julienrat/petitbot/Shield/readme.md

## Shield Petit Bot
Fichier Gerber utilisable directement sur le site JCLPCB : [https://jlcpcb.com/]

| DESSUS  | DESSOUS |
| --- | --- |
| My Image | My Image |

N'oubliez pas de paneliser en indiquant Panel by JCLPCB, 4 colonnes et 3 lignes. 

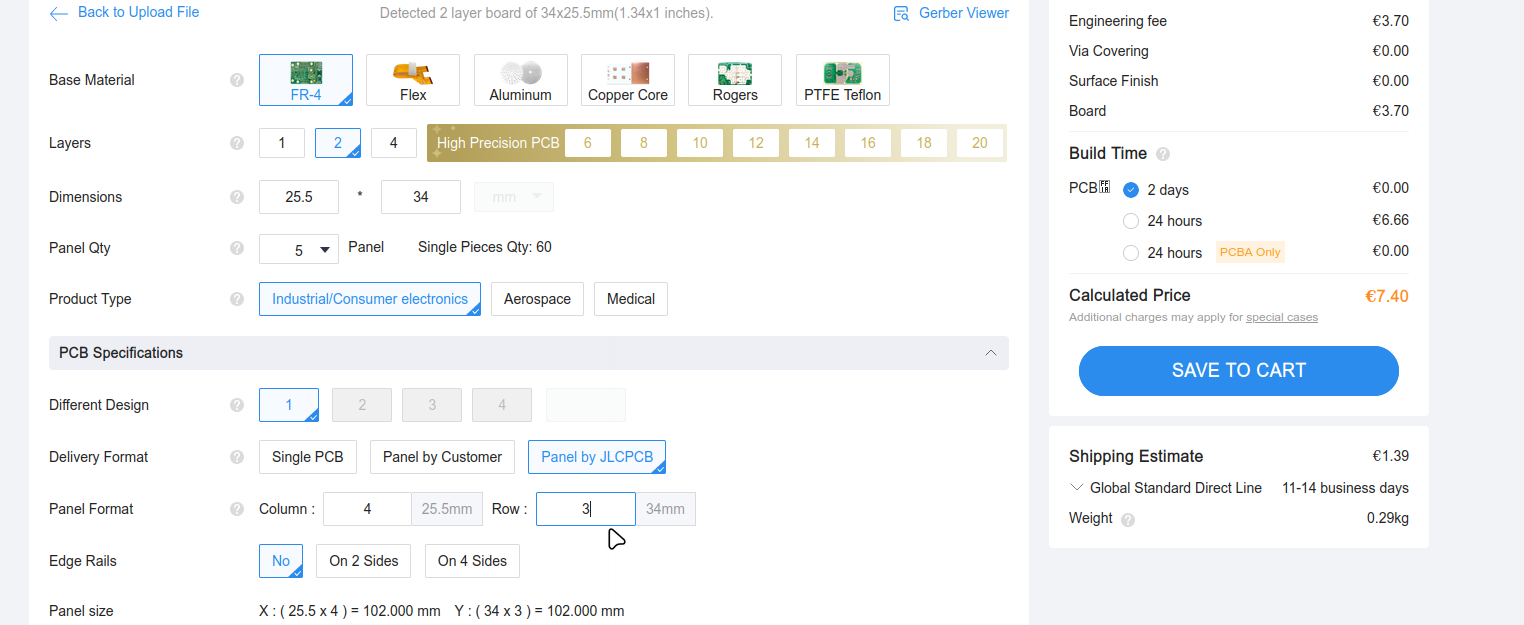
[picture p13: Shield/JCLPCB_TUTO.png]
My Image
