julienrat/petitbot/code_arduino/petitbot_v4/readme.md

ATTENTION ! ce code fonctionne désormais avec la derniere version la bibliothèque ArduinoJson v6
