julienrat/petitbot/code_arduino/petitbot_v4/data/images/bot_carton.jpg

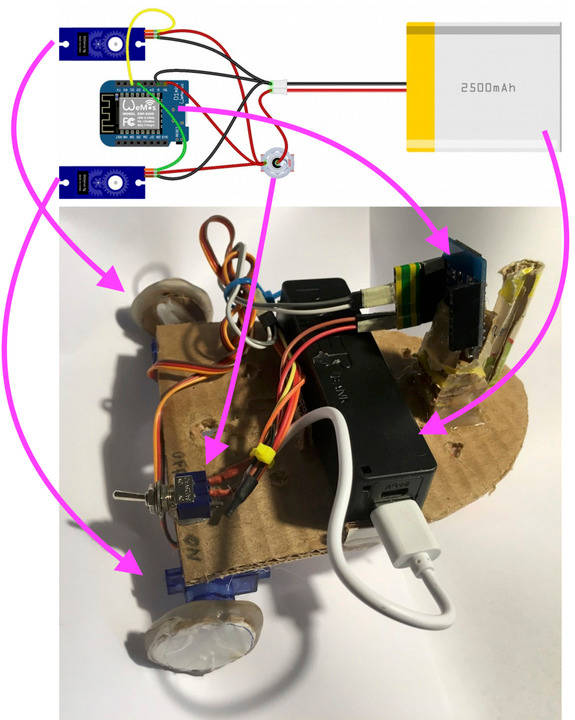
code_arduino/petitbot_v4/data/images/bot_carton.jpg
