julienrat/petitbot/code_arduino/petitbot_v4/data/images/petitbot1.jpg

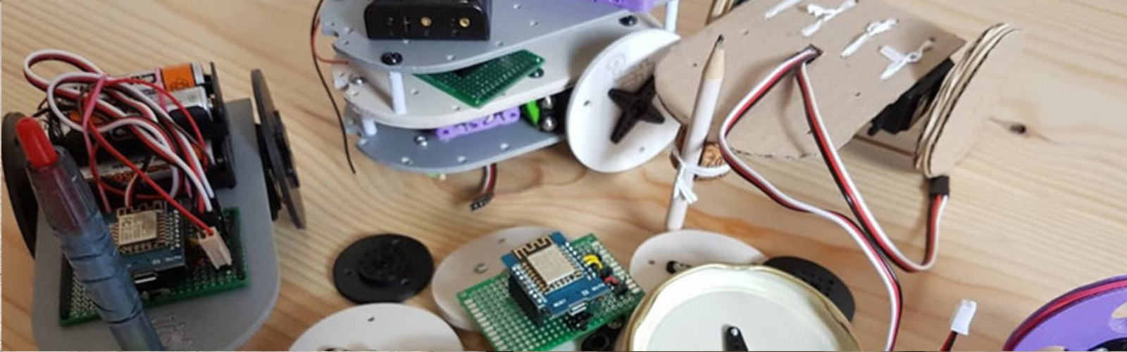
code_arduino/petitbot_v4/data/images/petitbot1.jpg
