julienrat/petitbot/code_arduino/petitbot_v4/data/images/petitbot4_low.jpg

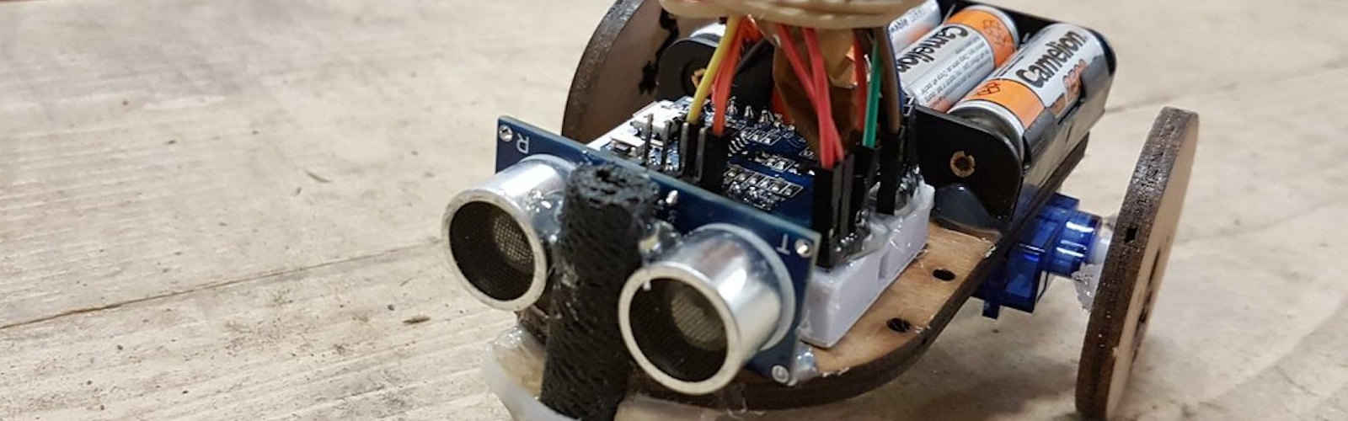
code_arduino/petitbot_v4/data/images/petitbot4_low.jpg
