julienrat/petitbot/code_arduino/petitbot_v4/data/images/servo.jpg

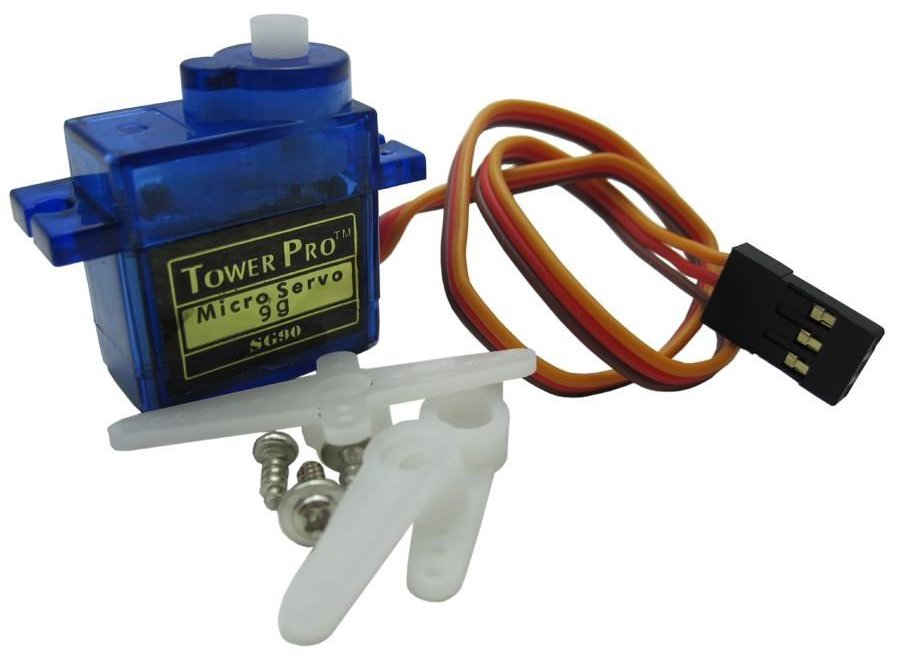
code_arduino/petitbot_v4/data/images/servo.jpg
