julienrat/petitbot/code_arduino/petitbot_v4/data/images/servo_colle.jpg

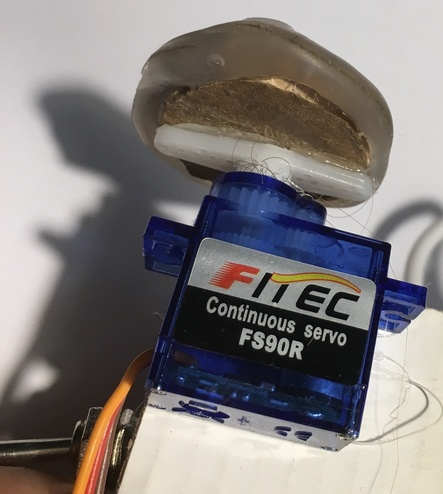
code_arduino/petitbot_v4/data/images/servo_colle.jpg
