julienrat/petitbot/images/5-pcs-9g-Mini-360-Degree-Continuous-Rotation-Robot-Servo-FS90R.jpg

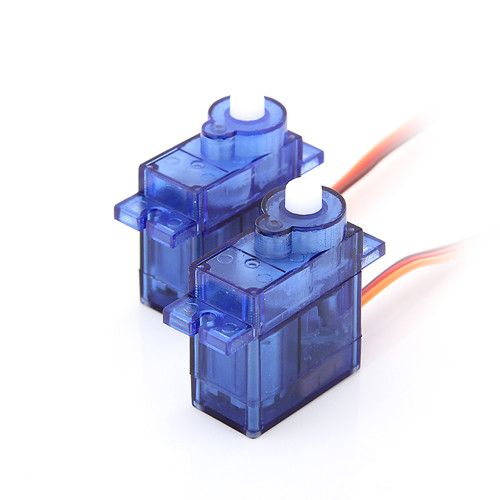
images/5-pcs-9g-Mini-360-Degree-Continuous-Rotation-Robot-Servo-FS90R.jpg
