julienrat/petitbot/images/10-Pcs-Per-Lot-font-b-2mm-b-font-font-b-Pitch-b-font-8-Pin.jpg

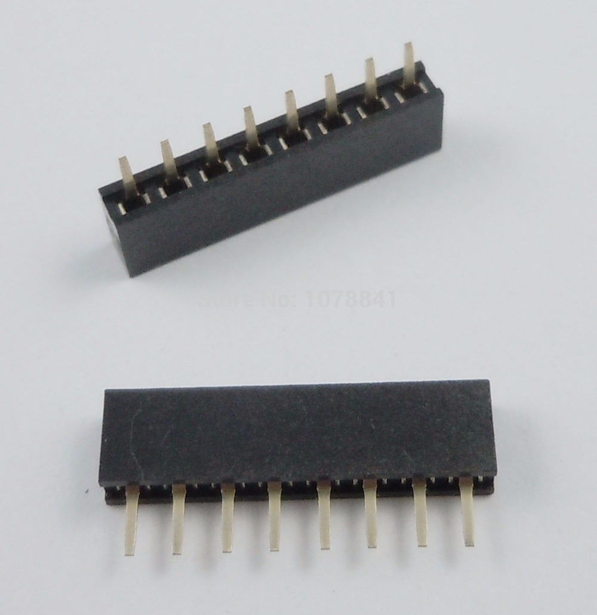
images/10-Pcs-Per-Lot-font-b-2mm-b-font-font-b-Pitch-b-font-8-Pin.jpg
