julienrat/petitbot/images/701343_ZB_00_FB.EPS_1000.jpg

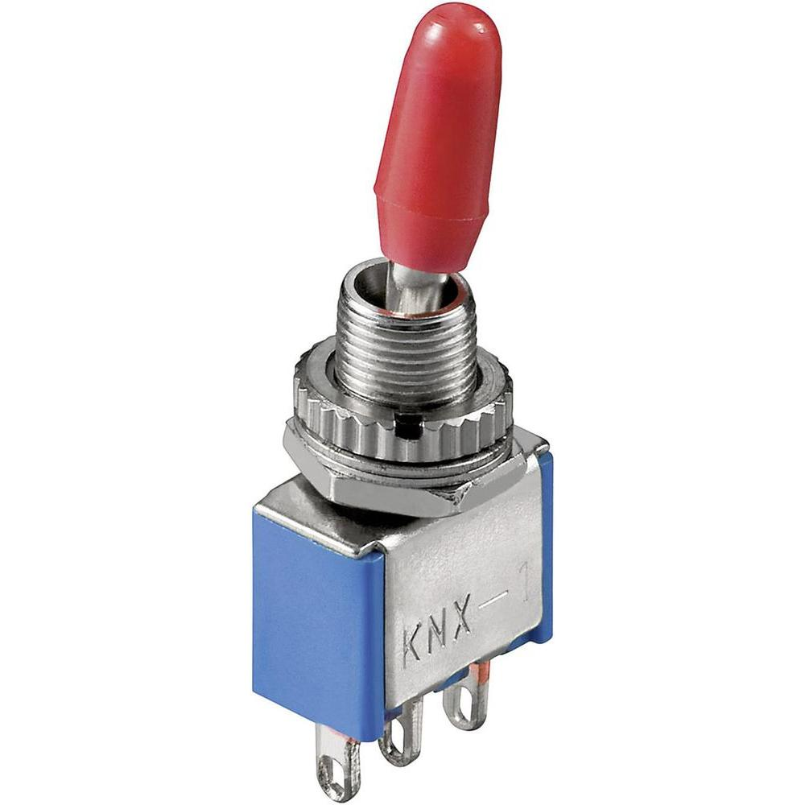
images/701343_ZB_00_FB.EPS_1000.jpg
