julienrat/petitbot/images/20170923_175443.jpg

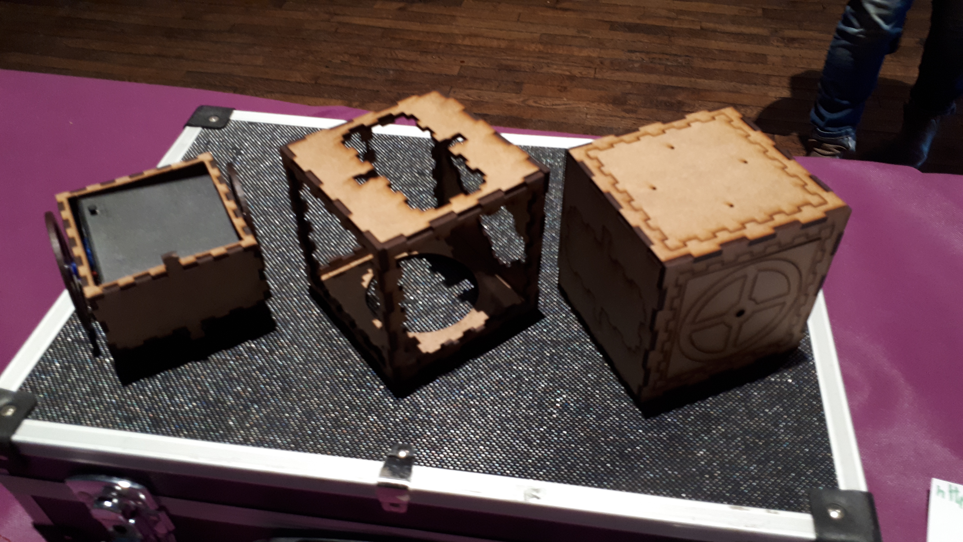
images/20170923_175443.jpg
