julienrat/petitbot/images/appinventor2.png

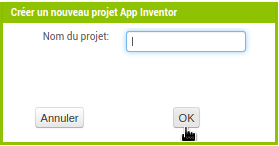
images/appinventor2.png
