julienrat/petitbot/images/appinventor3.png

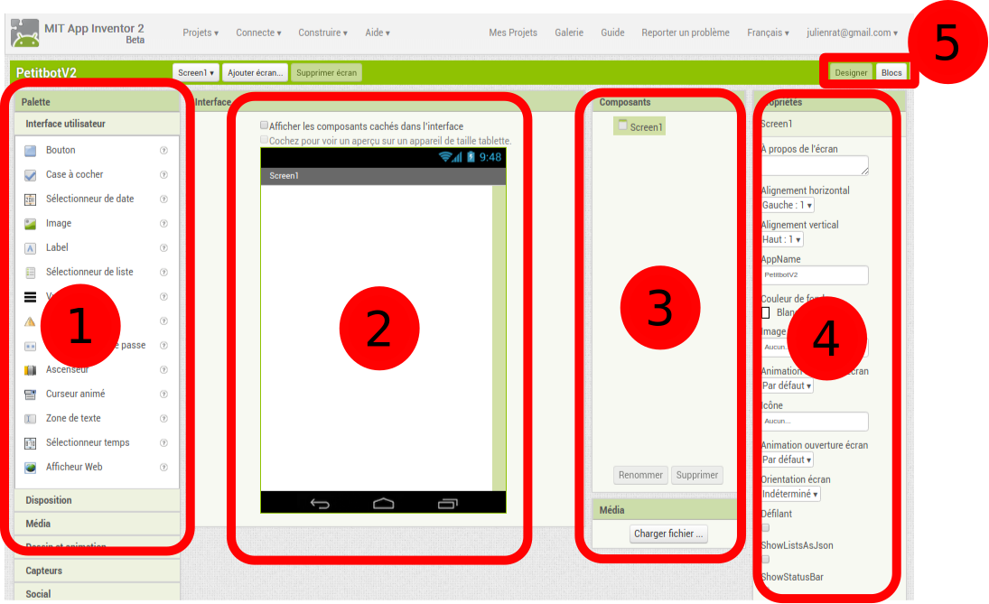
images/appinventor3.png
