julienrat/petitbot/images/appinventor5.png

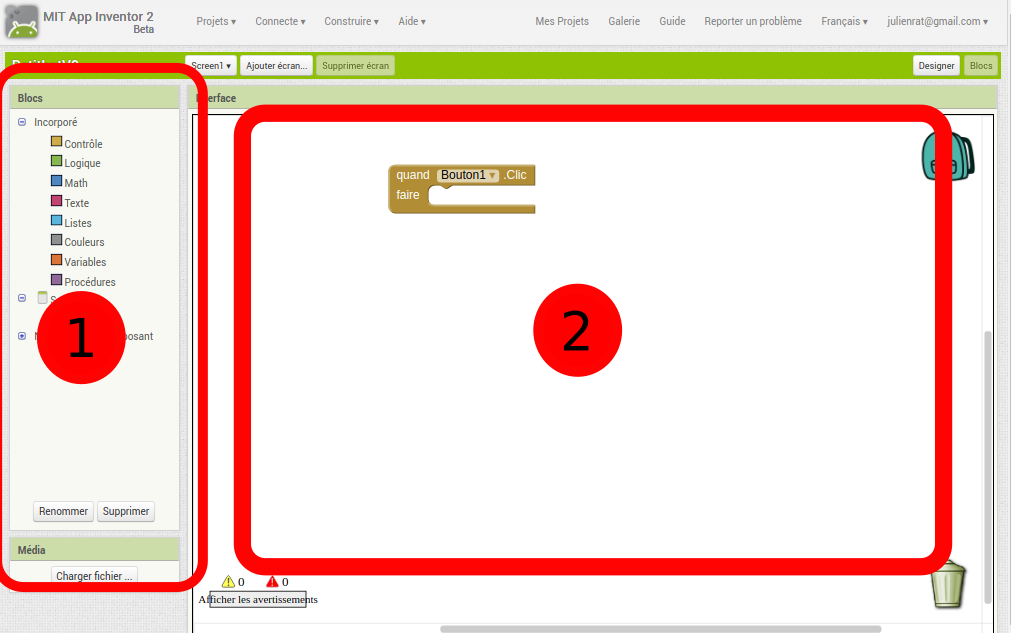
images/appinventor5.png
