julienrat/petitbot/images/appinventor6.png

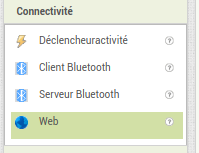
images/appinventor6.png
