julienrat/petitbot/images/appinventor7.png

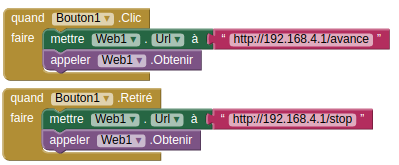
images/appinventor7.png
