julienrat/petitbot/images/appinventor9.png

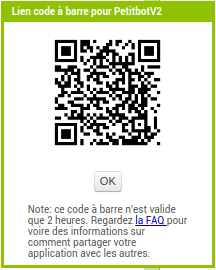
images/appinventor9.png
