julienrat/petitbot/images/C3WkAJDWcAAZ7_t.jpg

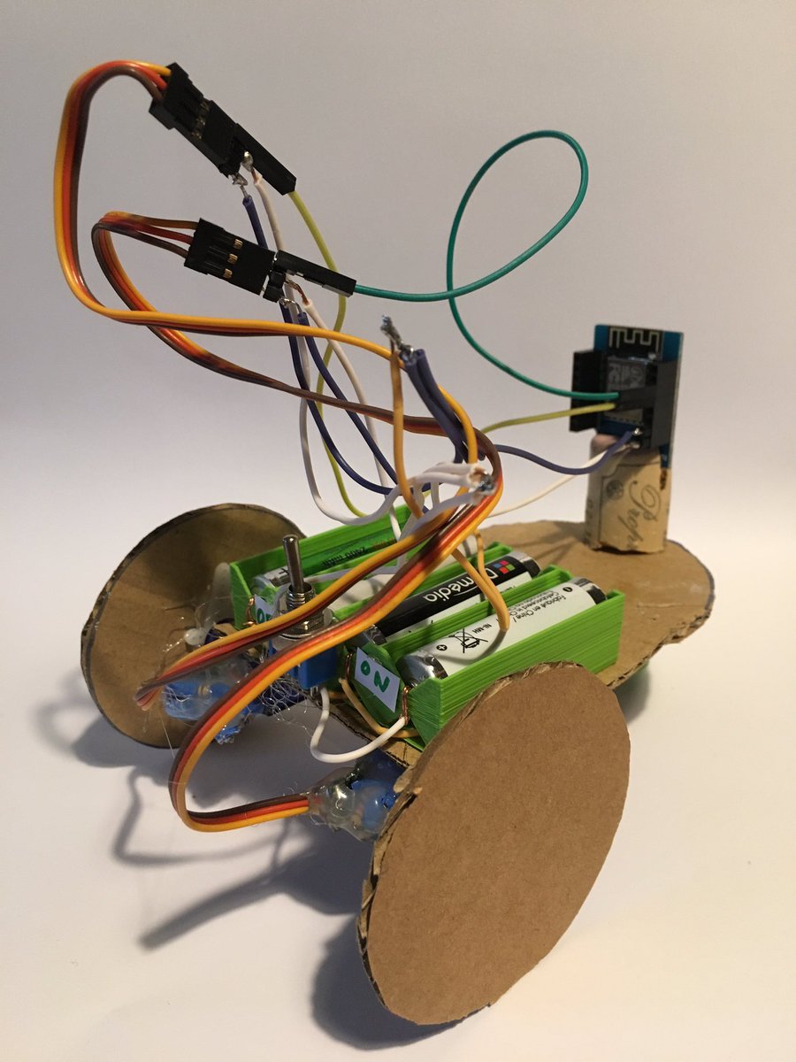
images/C3WkAJDWcAAZ7_t.jpg
