julienrat/petitbot/images/C3WkAJdWcAIOfmc.jpg

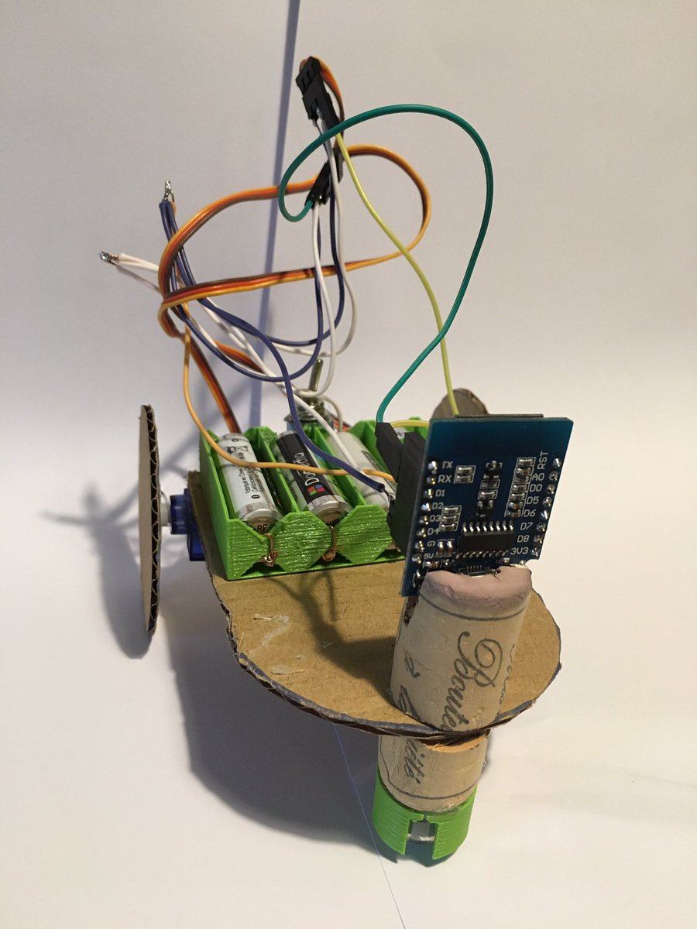
images/C3WkAJdWcAIOfmc.jpg
