julienrat/petitbot/images/C6-DNaoXAAEp5Ra.jpg

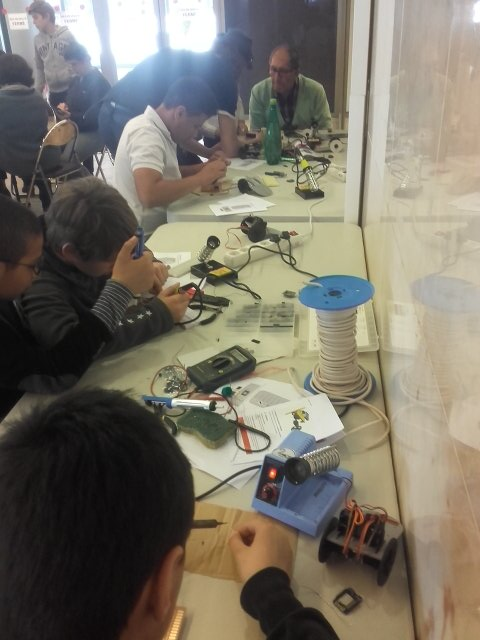
images/C6-DNaoXAAEp5Ra.jpg
