julienrat/petitbot/images/C6-DO8nXEAAV2lQ.jpg

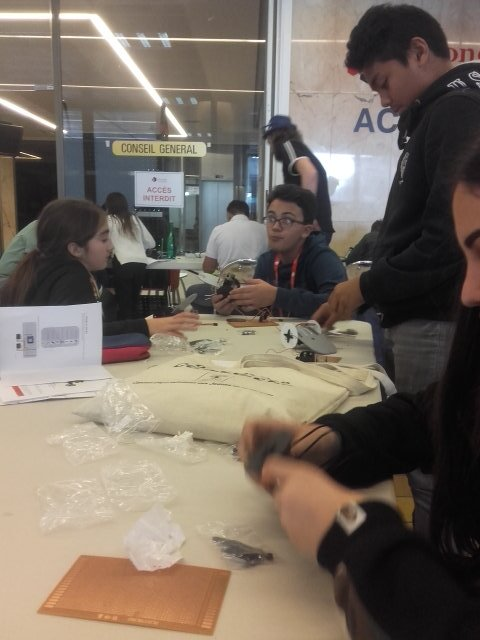
images/C6-DO8nXEAAV2lQ.jpg
