julienrat/petitbot/images/C-5D0mgXoAE_1XM.jpg

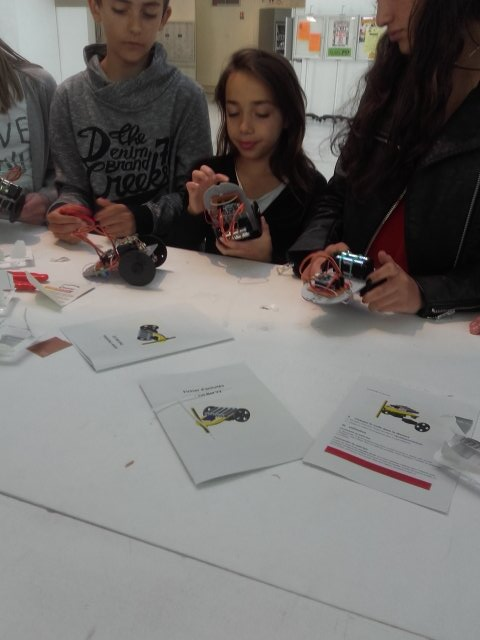
images/C-5D0mgXoAE_1XM.jpg
