julienrat/petitbot/images/C-5DqKEXUAAd2nf.jpg

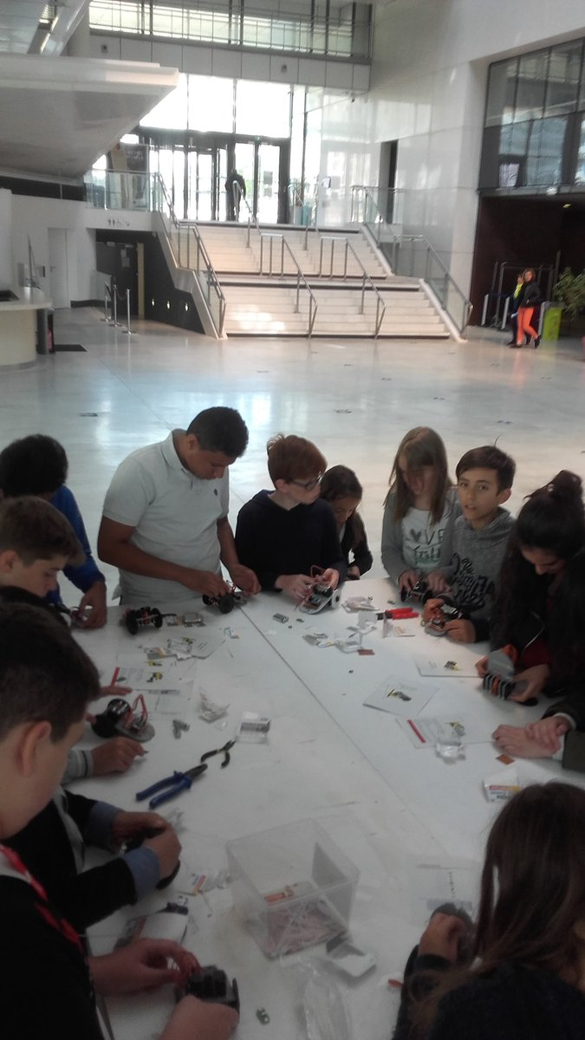
images/C-5DqKEXUAAd2nf.jpg
