julienrat/petitbot/images/C-5DtmpW0AE9u2l.jpg

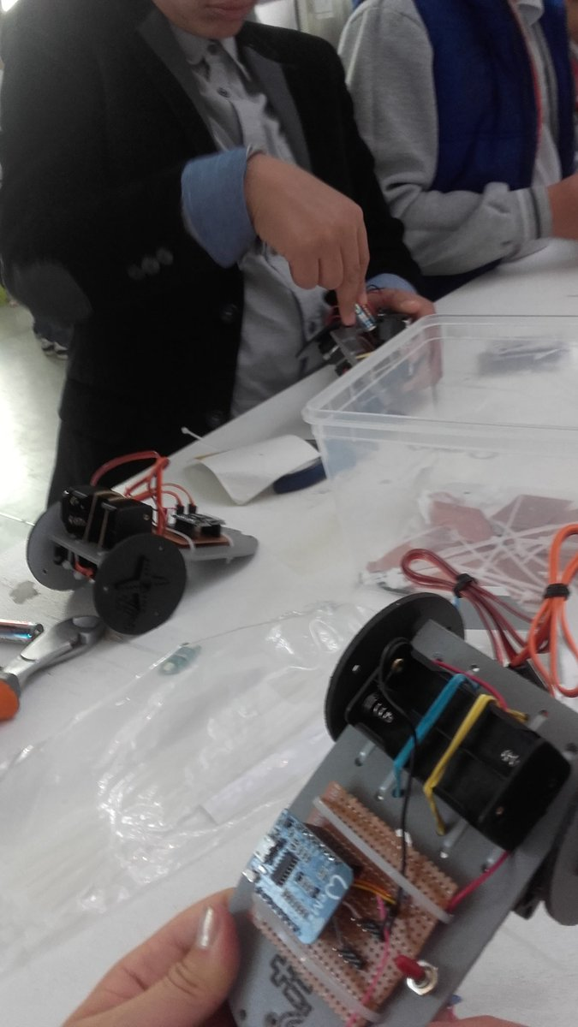
images/C-5DtmpW0AE9u2l.jpg
