julienrat/petitbot/images/C-5Dx54XUAElF1G.jpg

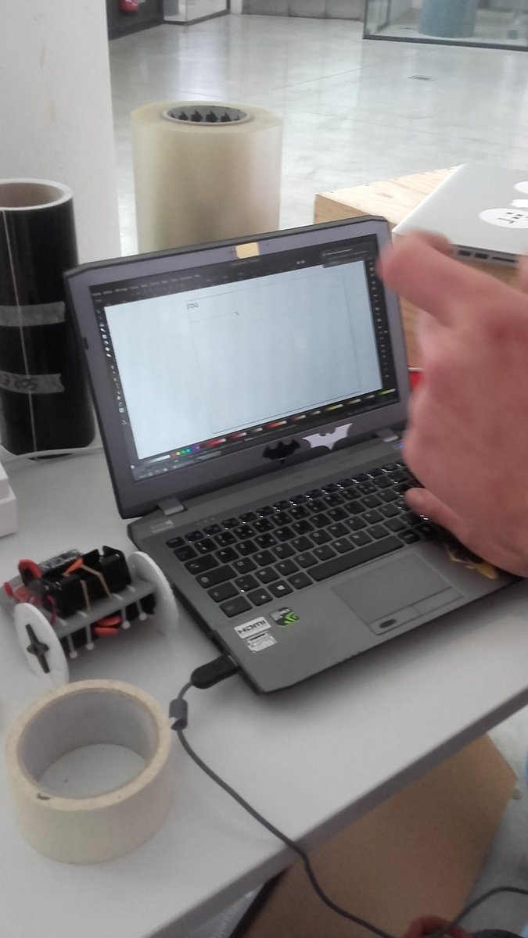
images/C-5Dx54XUAElF1G.jpg
