julienrat/petitbot/images/chassis-300x204.png

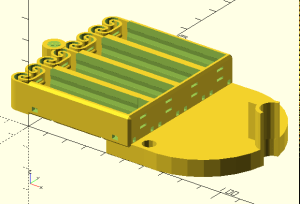
images/chassis-300x204.png
