julienrat/petitbot/images/connexion_nextcloud.gif

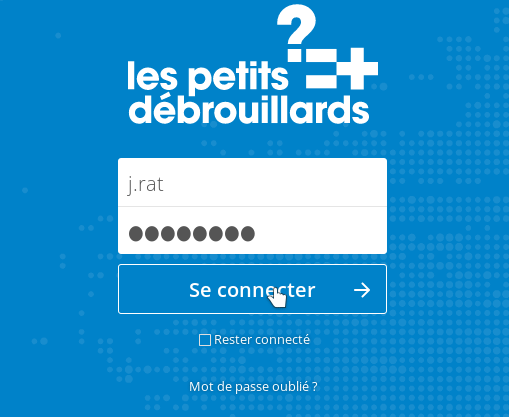
images/connexion_nextcloud.gif
