julienrat/petitbot/images/F5487216-01.jpg

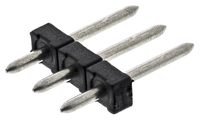
images/F5487216-01.jpg
