julienrat/petitbot/images/HCR-04.png

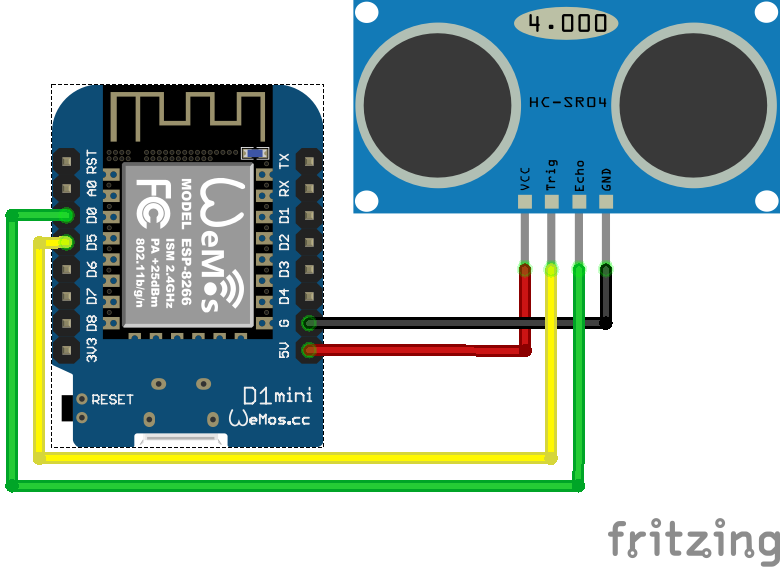
images/HCR-04.png
