julienrat/petitbot/images/petit_bot.jpg

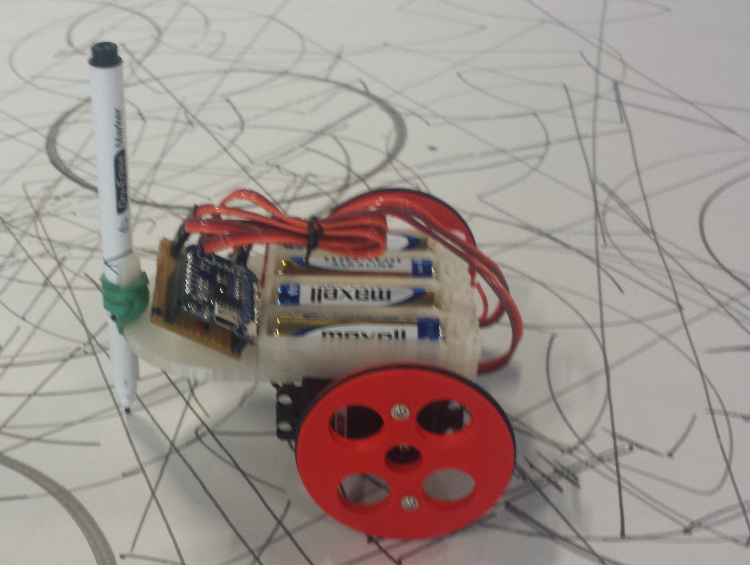
images/petit_bot.jpg
