julienrat/petitbot/images/PETITBOT_circuit imprimé.png

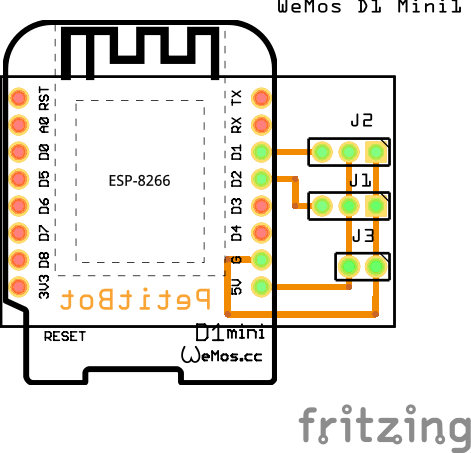
images/PETITBOT_circuit imprimé.png
