julienrat/petitbot/images/PETITBOT_schéma.png

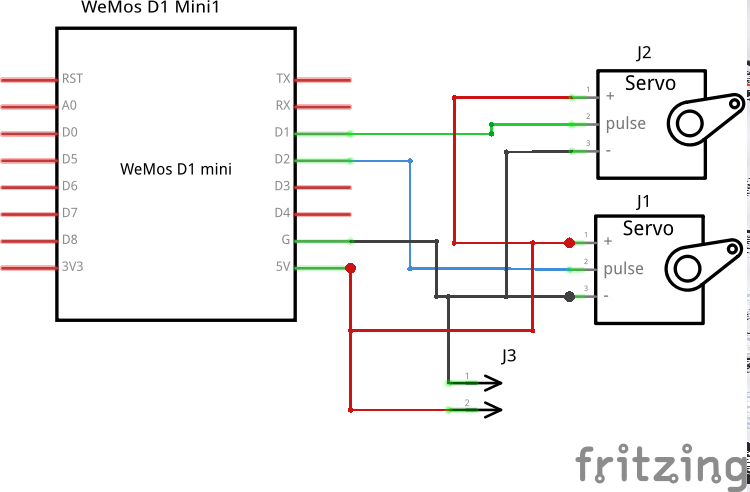
images/PETITBOT_schéma.png
