julienrat/petitbot/images/photo_res.png

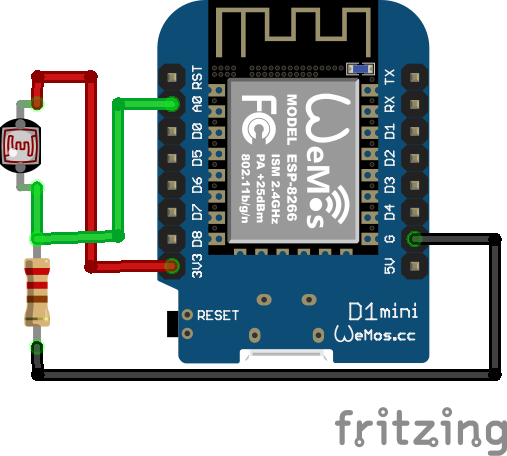
images/photo_res.png
