julienrat/petitbot/images/roue-300x223.png

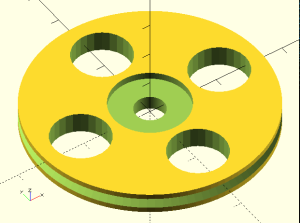
images/roue-300x223.png
