julienrat/petitbot/images/snap1.png

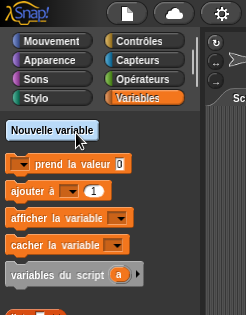
images/snap1.png
