julienrat/petitbot/images/snap2.png

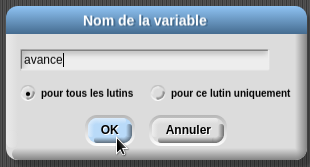
images/snap2.png
