julienrat/petitbot/images/snap3.png

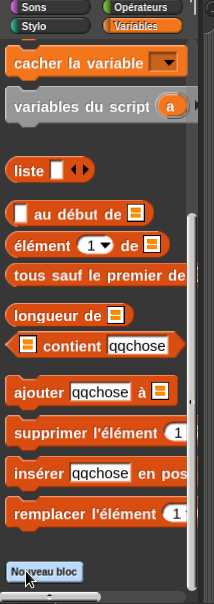
images/snap3.png
