julienrat/petitbot/images/snap4.png

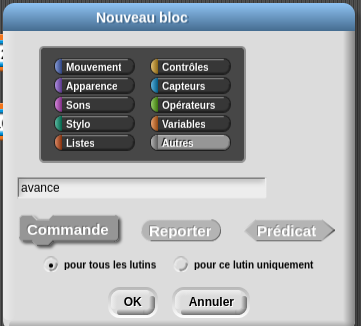
images/snap4.png
