julienrat/petitbot/images/snap5.png

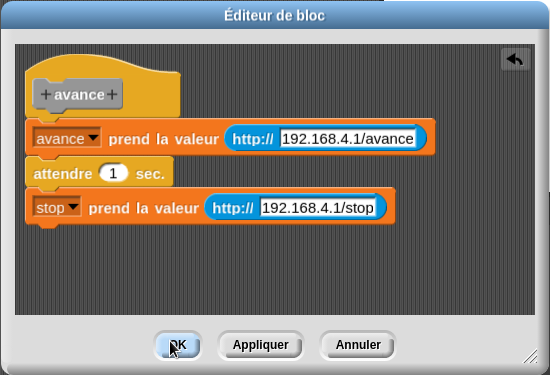
images/snap5.png
