julienrat/petitbot/images/snap7.png

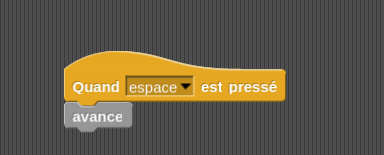
images/snap7.png
