julienrat/petitbot/images/snap8.png

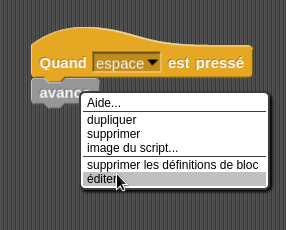
images/snap8.png
