julienrat/petitbot/images/Wemos_D1_mini.jpg

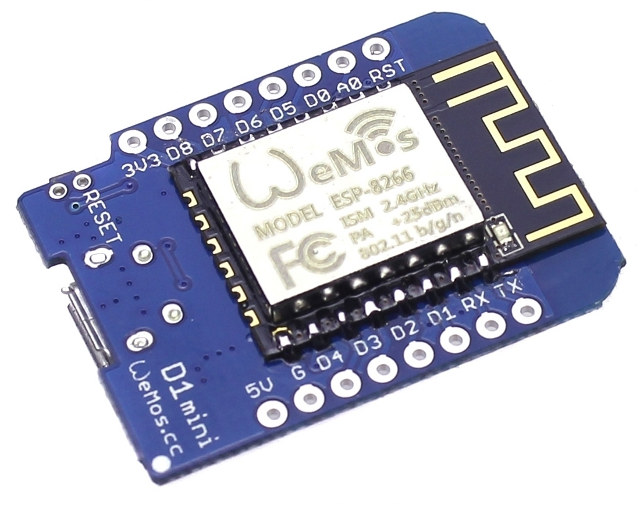
images/Wemos_D1_mini.jpg
