julienrat/petitbot/images/WSFS-Hot-8-Plastic-Cable-Zip-Ties-100-Pack-Black-.jpg_220x220.jpg

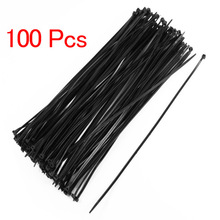
images/WSFS-Hot-8-Plastic-Cable-Zip-Ties-100-Pack-Black-.jpg_220x220.jpg
