julienrat/petitbot/impressions_3D/chassis.png

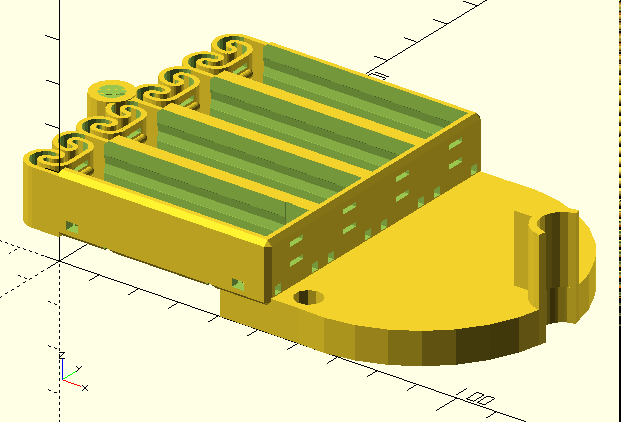
impressions_3D/chassis.png
