julienrat/petitbot/impressions_3D/petitbot_9g_battery_less.stl

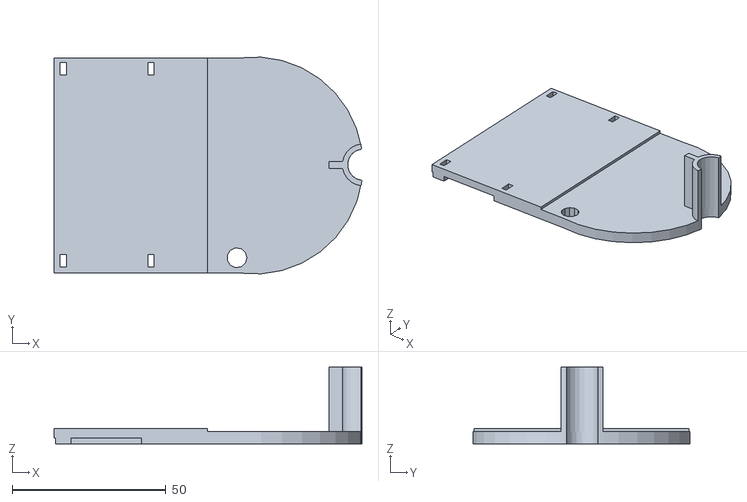
[picture p62: CAD file, 2018-12-12]
impressions_3D/petitbot_9g_battery_less.stl
100.2 x 70.5 x 25.0
