julienrat/petitbot/impressions_3D/petitbot-V2.stl

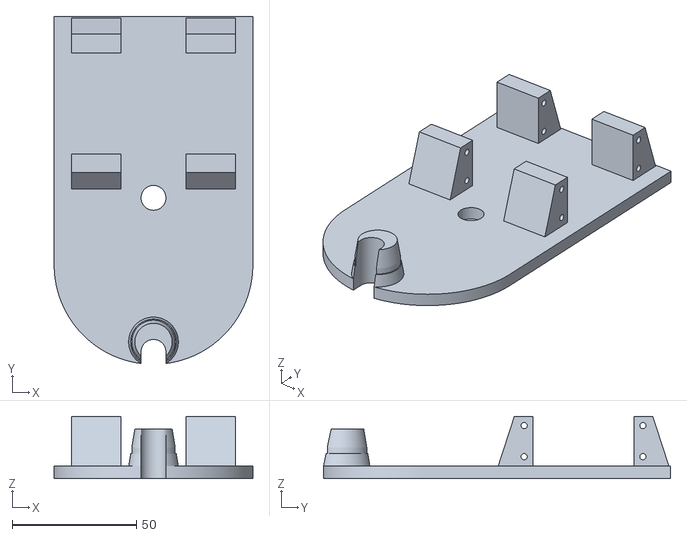
[picture p63: CAD file, 2017-03-10]
impressions_3D/petitbot-V2.stl
80.0 x 139.7 x 25.0
