julienrat/petitbot/impressions_3D/roue.stl

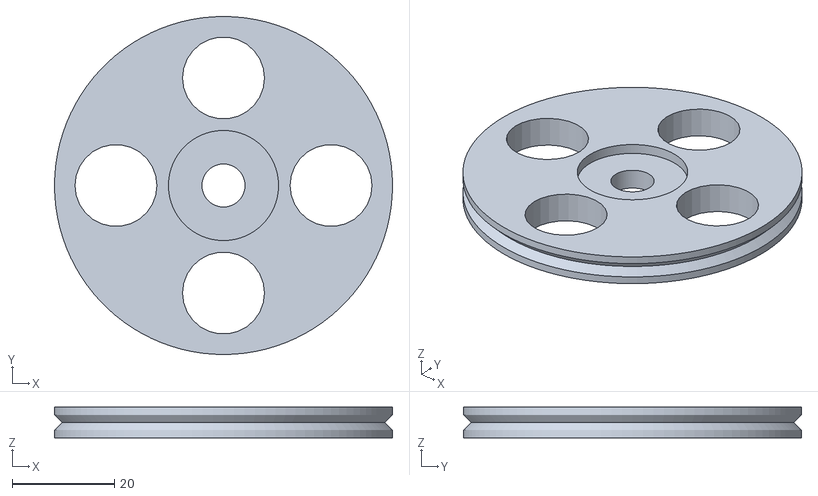
[picture p64: CAD file, 2016-04-13]
impressions_3D/roue.stl
66.0 x 66.0 x 6.00
