julienrat/petitbot/impressions_3D/chassis_servo_9g.stl

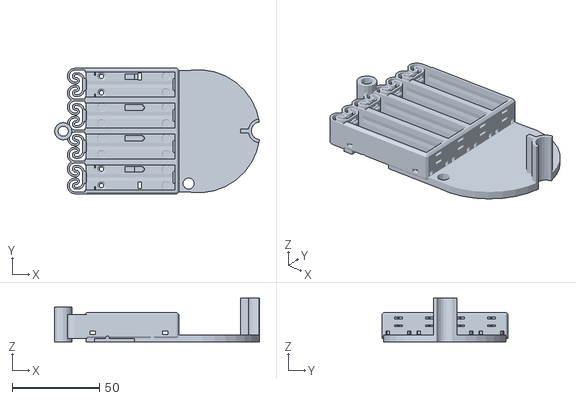
[picture p65: CAD file, 2016-04-13]
impressions_3D/chassis_servo_9g.stl
117.7 x 72.2 x 25.0
