julienrat/petitbot/impressions_3D/chassis.stl

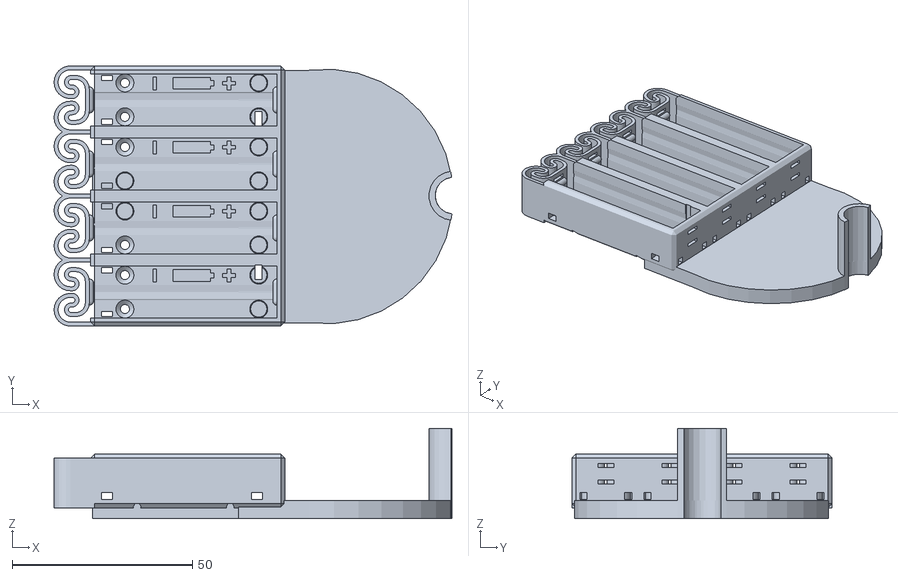
[picture p66: CAD file, 2016-04-09]
impressions_3D/chassis.stl
110.3 x 72.2 x 25.0
