julienrat/petitbot/impressions_3D/support_ili.scad

 linear_extrude(height = 8, center = false, convexity = 10)
   import (file = "chassis.dxf",layer="2");
