julienrat/petitbot/(list of files, cad)

Other CAD files:
impressions_3D/chassis.scad
impressions_3D/chassis.dxf
impressions_3D/chassis_servo_9g.dxf
