julienrat/petitbot/code_arduino/petitbot_v4/data/images/montage.jpg

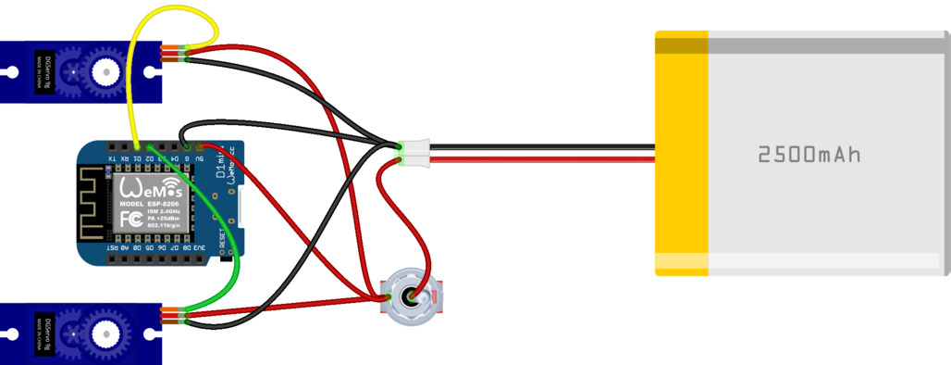
code_arduino/petitbot_v4/data/images/montage.jpg
