julienrat/petitbot/(threads)

Thread 3 (2017-10-23):

Licence

Rom1deTroyes, 2017-10-23:
Le Bonjour !

On utilise pas mal le petitbot sur l'antenne Petits Débrouillards de Brest, et dans le cadre des Fabriques du Ponant, on est amenés a bidouiller le code, les fichiers 3D et la documentation du projet pour l'adapter à nos ateliers.

Si je n'ai aucun doutes sur ton consentement pour l'utilisation de tout ça pour les Petits Debs, je me pose la question des contributions personnelles de chacun, et du cadre légal de tout ça...

Serait-il possible d'apposer une licence sur le projet pour lever toute ambiguïté ?

++
    Romain
