julienrat/petitbot/(list of files, drawings)

Other design files:
PETITBOT.fzz
Shield/sources Easy eda/PCB_PCB_PetitBot-shield_2024-03-28.json
Shield/sources Easy eda/SCH_PetitBot-shield_2024-03-28.json
