julienrat/petitbot/code_arduino/petitbotESP/pin_map.h

const int pin_led1 = 3; // pin led 1
const int pin_led2 = 1; // pin led 2
// Recommended PWM GPIO pins on the ESP32 include 2,4,12-19,21-23,25-27,32-33 
int pin_servoG = 2; // pin servo gauche
int pin_servoD = 4; // pin servo droit

const int pin_servo1 = 12; // pin servo 1
const int pin_servo2 = 13; // pin servo 2
const int pin_servo3 = 14; // pin servo 3

const int pin_dist1 = 5; // pin capteur de distance 1
const int pin_dist2 = 0; // pin capteur de distance 2
