julienrat/petitbot/(commit log)

2016-04-07 + ‘.sparkleshare’ + ‘SparkleShare.txt’
2016-04-07 + ‘readme.txt’
2016-04-09 + ‘PETITBOT.fzz’ + ‘PETITBOT_bb.png’ + ‘PETITBOT_circuit imprimé.png’ + ‘code_arduino/petitbot.ino’ + ‘impressions_3D/chassis.dxf’ + ‘impressions_3D/chassis.scad’ + ‘impressions_3D/chassis.stl’ + ‘pe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
    [PETITBOT.fzz, chassis.dxf, chassis.scad, chassis.stl]
2016-04-09 + ‘impressions_3D/chassis’
2016-04-09 < ‘impressions_3D/chassis’ > ‘impressions_3D/chassis.png’
2016-04-09 + ‘impressions_3D/roue.scad’
    [roue.scad]
2016-04-09 / ‘impressions_3D/roue.scad’
    [roue.scad]
2016-04-09 + ‘impressions_3D/roue.png’
2016-04-09 / ‘impressions_3D/chassis.png’
2016-04-09 + ‘application_android/’
2016-04-09 + ‘application_android/petit_bot.apk’
2016-04-09 + ‘application_android/static_qr_code_without_logo.jpg’
2016-04-09 < ‘application_android/static_qr_code_without_logo.jpg’ > ‘application_android/qrcode.jpg’
2016-04-09 - ‘application_android/qrcode.jpg’
2016-04-09 + ‘petit_bot.jpg’
2016-04-09 + ‘petit_bot.png’
2016-04-09 / ‘petit_bot.jpg’ - ‘petit_bot.png’
2016-04-09 + ‘impressions_3D/#chassis.dxf’
    [#chassis.dxf]
2016-04-09 / ‘impressions_3D/#chassis.dxf’
    [#chassis.dxf]
2016-04-09 - ‘impressions_3D/#chassis.dxf’
    [#chassis.dxf]
2016-04-09 + ‘impressions_3D/chassis_servo_9g.dxf’
    [chassis_servo_9g.dxf]
2016-04-09 / ‘impressions_3D/chassis_servo_9g.dxf’
    [chassis_servo_9g.dxf]
2016-04-09 + ‘impressions_3D/chassis_servo_9g.scad’
    [chassis_servo_9g.scad]
2016-04-09 < ‘code_arduino/petitbot.ino’ > ‘code_arduino/petitbot/petitbot.ino’
2016-04-13 + ‘impressions_3D/chassis_servo_9g.stl’
    [chassis_servo_9g.stl]
2016-04-13 + ‘impressions_3D/roue.stl’
    [roue.stl]
2016-04-14 + ‘PETITBOT_schéma.png’
2016-04-14 / ‘PETITBOT.fzz’
    [PETITBOT.fzz]
2016-04-14 + ‘code_arduino/esp_bot.ino’
2016-04-14 < ‘code_arduino/esp_bot.ino’ > ‘code_arduino/petitbot_v2.ino’
2016-04-21 + ‘impressions_3D/support_ili.scad’
    [support_ili.scad]
2016-04-21 / ‘impressions_3D/support_ili.scad’
    [support_ili.scad]
2016-05-24 / ‘readme.txt’
2017-03-10 Ajout de la nouvelle version du chassis
    [petitbot-V2.stl]
2017-03-10 guide de démarrage petit bot
2017-05-11 + ‘guide_peda.odt’ + ‘manuel_tech_petitbot.odt’
2017-05-11 < ‘readme.txt’ > ‘readme.md’
2017-05-12 / ‘readme.md’
2017-05-12 + ‘nouveau dossier/’
2017-05-12 < ‘nouveau dossier/’ > ‘images/’
2017-05-12 < ‘PETITBOT_bb.png’ > ‘images/PETITBOT_bb.png’ < ‘PETITBOT_circuit imprimé.png’ > ‘images/PETITBOT_circuit imprimé.png’ < ‘PETITBOT_schéma.png’ > ‘images/PETITBOT_schéma.png’
2017-05-12 + ‘images/api_wemos.svg’ + ‘images/api_wemos.svg.png’
2017-05-12 + ‘images/10-Pcs-Per-Lot-font-b-2mm-b-font-font-b-Pitch-b-font-8-Pin.jpg’ + ‘images/5-pcs-9g-Mini-360-Degree-Continuous-Rotation-Robot-Servo-FS90R.jpg’ + ‘images/701343_ZB_00_FB.EPS_1000.jpg’
2017-05-12 + ‘images/F5487216-01.jpg’ / ‘images/PETITBOT_bb.png’ + ‘images/WSFS-Hot-8-Plastic-Cable-Zip-Ties-100-Pack-Black-.jpg_220x220.jpg’ + ‘images/Wemos_D1_mini.jpg’ + ‘images/appinventor1.png’ + ‘images/a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
2017-05-12 < ‘petit_bot.jpg’ > ‘images/petit_bot.jpg’
2017-05-12 + ‘images/C3WkAJDWcAAZ7_t.jpg’
2017-05-12 + ‘images/C3WkAJdWcAIOfmc.jpg’
2017-05-12 + ‘images/C6-DO8nXEAAV2lQ.jpg’
2017-05-12 + ‘images/C6-DNaoXAAEp5Ra.jpg’
2017-05-12 + ‘images/C-5DqKEXUAAd2nf.jpg’
2017-05-12 + ‘images/C-5Dx54XUAElF1G.jpg’
2017-05-12 + ‘images/C-5D0mgXoAE_1XM.jpg’
2017-05-12 + ‘images/C-5DtmpW0AE9u2l.jpg’
2017-05-12 / ‘guide_peda.odt’
2017-05-12 + ‘images/HCR-04.png’
2017-05-12 + ‘images/photo_res.png’
2017-05-12 + ‘snap/’
2017-05-12 + ‘snap/snap.xml’
2017-05-12 + ‘snap/snap.zip’
2017-05-12 + ‘images/snap9.png’
2017-05-12 + ‘images/snap10.png’
2017-05-12 / ‘guide_peda.pdf’
2017-05-12 < ‘code_arduino/petitbot_v2.ino’ > ‘code_arduino/petitbot_v2/petitbot_v2.ino’
2017-05-12 / ‘code_arduino/petitbot_v2/petitbot_v2.ino’
2017-05-13 / ‘images/HCR-04.png’
2017-09-06 + ‘manuel_tech_petitbot.pdf’
2017-09-17 + ‘application_android/scripts_app-inventor/’
2017-09-17 + ‘application_android/scripts_app-inventor/Telecommande_PetitBot_V2.aia’ + ‘application_android/scripts_app-inventor/petitbot.aia’
2017-09-23 + ‘snap/petitbot.xml’
2017-09-25 + ‘images/20170923_175255.jpg’
2017-09-25 + ‘images/20170923_175443.jpg’
2017-09-25 + ‘fichiers_découpe/’
2017-09-25 + ‘fichiers_découpe/Pack_Petit_Bot_6.svg’
2017-11-24 + ‘code_arduino/petitbot_v3/’
2017-11-24 + ‘code_arduino/data/block.css’ + ‘code_arduino/data/block.html’ + ‘code_arduino/data/block.js’ + ‘code_arduino/data/bootstrap/css/bootstrap.css’ + ‘code_arduino/data/bootstrap/fonts/glyphicons-halfl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
    [config.txt]
2017-11-24 - ‘code_arduino/data/block.css’ - ‘code_arduino/data/block.html’ - ‘code_arduino/data/block.js’ - ‘code_arduino/data/bootstrap/css/bootstrap.css’ - ‘code_arduino/data/bootstrap/fonts/glyphicons-halfl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
    [config.txt]
2017-11-24 + ‘code_arduino/petitbot_v3/data/block.css’ + ‘code_arduino/petitbot_v3/data/block.html’ + ‘code_arduino/petitbot_v3/data/block.js’ + ‘code_arduino/petitbot_v3/data/bootstrap/css/bootstrap.css’ + ‘co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
    [config.txt]
2017-11-24 + ‘code_arduino/nouveau dossier/’
2017-11-24 < ‘code_arduino/nouveau dossier/’ > ‘code_arduino/binaires/’
2017-11-24 + ‘code_arduino/binaires/nouveau dossier/’
2017-11-24 < ‘code_arduino/binaires/nouveau dossier/’ > ‘code_arduino/binaires/petitbot_v3/’
2017-11-24 + ‘code_arduino/binaires/petitbot_v3/petitbot_v3.ino.d1_mini.bin’
2017-11-24 + ‘code_arduino/binaires/petitbot_v3/petitbot_v3.spiffs.bin’
2017-11-24 / ‘code_arduino/binaires/petitbot_v3/petitbot_v3.ino.d1_mini.bin’
2017-11-24 / ‘code_arduino/binaires/petitbot_v3/petitbot_v3.spiffs.bin’
2017-11-24 / ‘code_arduino/petitbot_v3/data/block.html’ / ‘code_arduino/petitbot_v3/data/config.html’ / ‘code_arduino/petitbot_v3/data/doc.html’ / ‘code_arduino/petitbot_v3/data/index.html’ / ‘code_arduino/peti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
2017-11-24 / ‘code_arduino/petitbot_v3/petitbot_v3.ino’
2017-12-07 + ‘flasher_petitbot.zip’
2017-12-07 + ‘images/Capture.PNG’ + ‘images/Capture2.PNG’ + ‘images/Capture3.PNG’
2018-03-07 < ‘readme.md’ > ‘readme_old.md’
2018-03-07 + ‘readme.md’
2018-03-07 - ‘readme.md’
2018-03-07 < ‘readme_old.md’ > ‘readme.md’
2018-06-08 + ‘code_arduino/petitbot_v3/Nouveau dossier/’
2018-06-08 < ‘code_arduino/petitbot_v3/Nouveau dossier/’ > ‘code_arduino/petitbot_v3/libraries/’
2018-06-08 + ‘code_arduino/petitbot_v3/libraries/ArduinoJson.zip’ + ‘code_arduino/petitbot_v3/libraries/ESPAsyncTCP-master.zip’ + ‘code_arduino/petitbot_v3/libraries/ESPAsyncWebServer-master.zip’ + ‘code_arduin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
2018-06-08 + ‘images/install_wemos.gif’
2018-06-08 + ‘images/choix_carte.gif’
2018-06-08 + ‘images/choix_port.gif’
2018-06-08 + ‘code_arduino/petitbot_v3/libraries/esp8266fs.jar’
2018-06-08 + ‘images/install_plugin.gif’
2018-06-08 + ‘images/upload_spiffs.gif’
2018-06-08 + ‘images/libs.gif’
2018-06-08 + ‘images/connexion_nextcloud.gif’
2018-06-08 + ‘code_arduino/petitbot_v3.zip’
2018-06-08 + ‘images/import.gif’
2018-06-08 + ‘images/upload.gif’
2018-06-08 + ‘images/spiffs_upload.gif’
2018-06-08 / ‘code_arduino/petitbot_v3.zip’
2018-06-08 + ‘code_arduino/petitbot_v3/petitbot_v3.ino.d1_mini.bin’
2018-06-29 ajout compatibilité ESP32
    [config.txt]
2019-09-20 Add arduinoJson librarie V6 compatibility
    [config.txt]
2024-03-28 Ajout de l'image du shield
2024-03-28 suppression de la version mal dessinée
2024-03-28 sources easy eda
    [PCB_PCB_PetitBot-shield_2024-03-28.json, SCH_PetitBot-shield_2024-03-28.json]
